pa3hcm/cubegen/case/stl/qube_bottom.stl

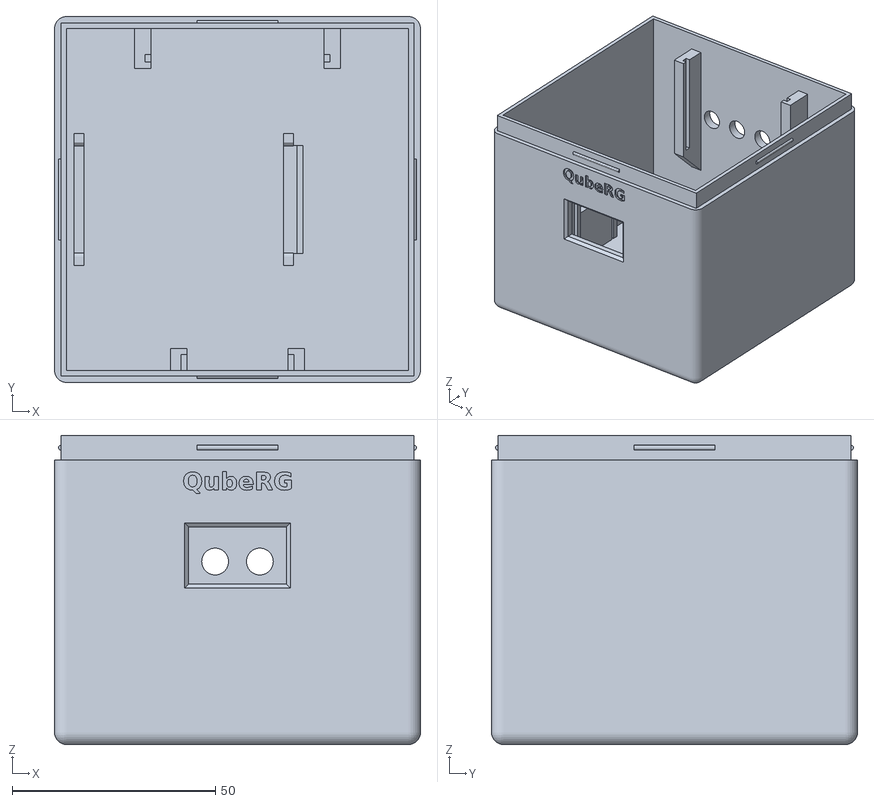
[picture p4: CAD file, 2026-11-14]
case/stl/qube_bottom.stl
90.0 x 90.0 x 76.0
