pa3hcm/cubegen/case/stl/qube_top.stl

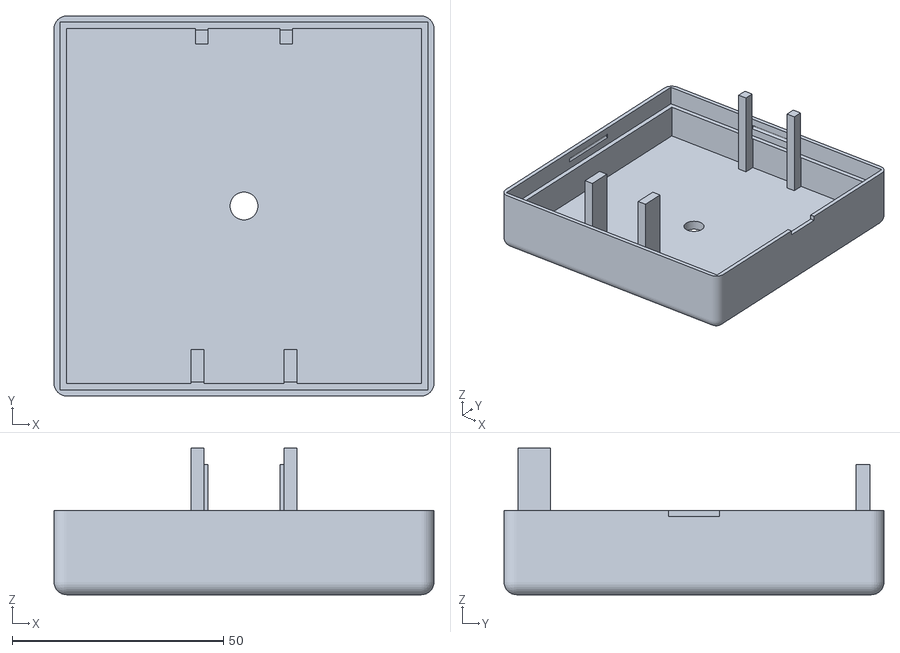
[picture p5: CAD file, 2026-11-14]
case/stl/qube_top.stl
90.0 x 90.0 x 34.7
