pa3hcm/cubegen/case/stl/qube_buttons.stl

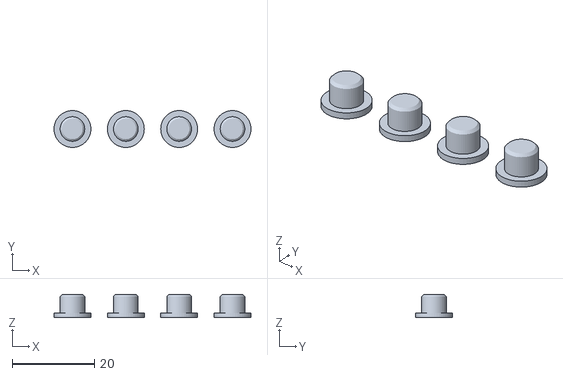
[picture p6: CAD file, 2026-11-14]
case/stl/qube_buttons.stl
48.0 x 9.00 x 5.70
