pa3hcm/cubegen/(commit log)

2026-11-11 cubeGen v0.1b: ESP32 + Si5351 RF signal generator
    PlatformIO firmware for ESP32 with Si5351 DDS, SSD1306 OLED and
    4 push buttons. Digit-wise frequency entry, modes CW, CW-keyed,
    FSK470, FSK850, FSK1K, FSK10K and OFF. Includes wiring diagram,
    README and PROMPT.md.
2026-11-14 Add 3D-printable cube case, product render, rename to QubeRG
    - case/qube_case.py: parametric case generator (manifold3d) with fit
    check against dummy boards; STLs for bottom, top and button caps
    - case/qube_preview.py: product image and inside view renders
    - README: product image in the intro, case section
    - Rename cubeGen -> QubeRG in code, docs and wiring diagram
    [qube_bottom.stl, qube_buttons.stl, qube_top.stl]
2026-11-14 Case: centre the SMA connector, mark the buttons
    - SMA bulkhead hole in the centre of the top panel; the Si5351 now
    hangs parallel to the front wall, right above the ESP32
    - Engrave up/down/D/M symbols above buttons 1..4
    - ESP32 cradle back to 20 mm to keep clearance under the Si5351
    [qube_bottom.stl, qube_top.stl]
2026-11-14 Case script: board-to-board fit check, size-relative layout
    - Fit check now also tests the boards against each other
    - Split height and display/button heights follow the cube size S
    - STLs unchanged (cube stays 90 mm)
